beeg-hardware/stepdown-pc/stepdown-pc.kicad_pcb

## KiCad design stepdown-pc.kicad_pcb (2022-09-27)

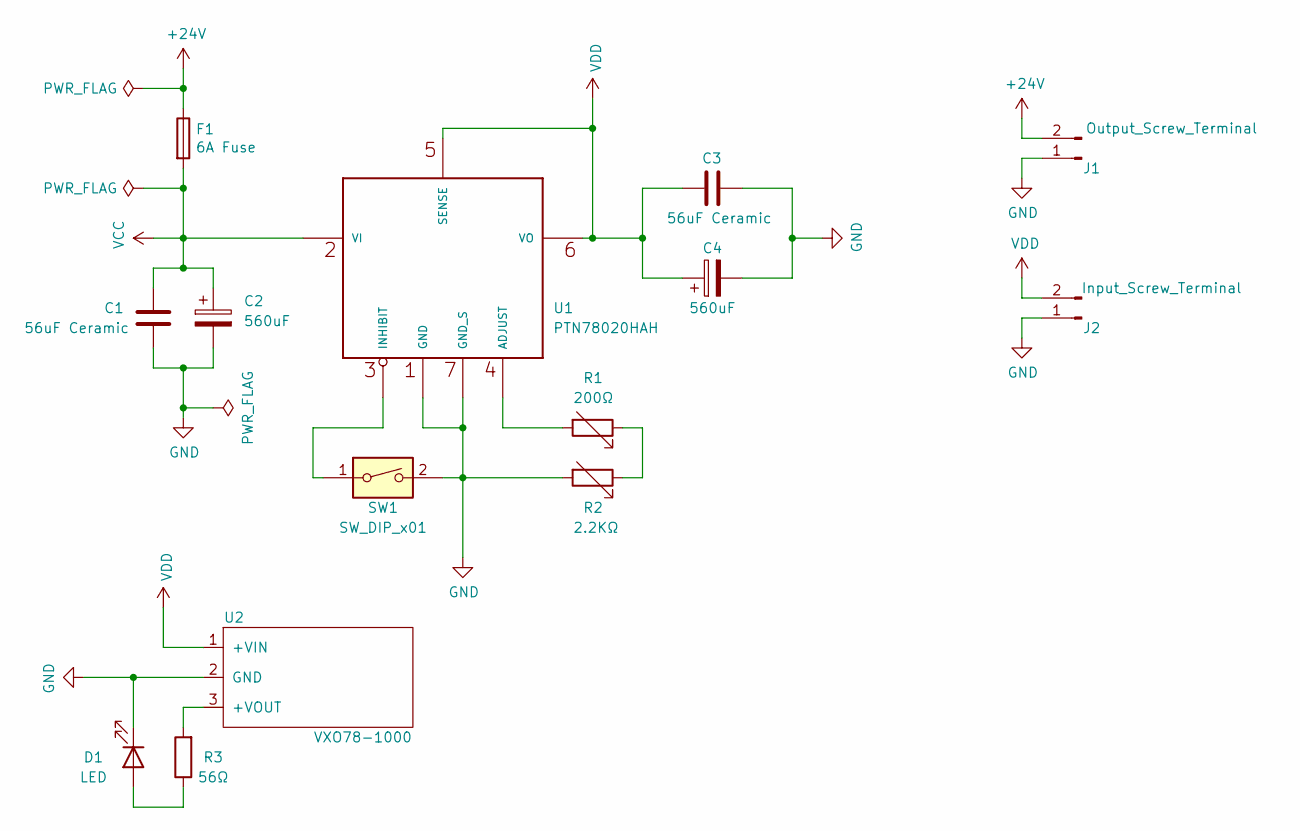
[picture p1: schematic stepdown-pc.kicad_sch, Stepdown PC]

Parts:
C1, C3: 56uF Ceramic; C_Rect_L7.0mm_W3.5mm_P5.00mm
C2, C4: 560uF; CP_Radial_D18.0mm_P7.50mm
D1: LED; LED_Rectangular_W3.0mm_H2.0mm
F1: 6A Fuse; Fuseholder_Cylinder-5x20mm_Littlelfuse_520_Horizontal_Open
J1: Output_Screw_Terminal; PhoenixContact_MSTBA_2,5_2-G-5,08_1x02_P5.08mm_Horizontal
J2: Input_Screw_Terminal; PhoenixContact_MSTBA_2,5_2-G-5,08_1x02_P5.08mm_Horizontal
R1: 200Ω; Potentiometer_Piher_Amphenol_PT-10-V10_Vertical_Hole
R2: 2.2KΩ; Potentiometer_Piher_Amphenol_PT-10-V10_Vertical_Hole
R3: 56Ω; R_Axial_DIN0207_L6.3mm_D2.5mm_P10.16mm_Horizontal
SW1: SW_DIP_x01; SW_DIP_SPSTx01_Slide_9.78x4.72mm_W7.62mm_P2.54mm
U1: PTN78020HAH
U2: VXO78-1000

Connections:
+24V: F1.1, J1.2
GND: C1.2, C2.2, C3.2, C4.2, D1.1 (K), J1.1, J2.1, R2.2, SW1.2, U1.1 (GND), U1.7 (GND_S), U2.2 (GND)
unnamed: D1.2 (A), R3.1
unnamed: R1.1, R2.1
unnamed: R1.2, U1.4 (ADJUST)
unnamed: R3.2, U2.3 (+VOUT)
unnamed: SW1.1, U1.3 (INHIBIT)
VCC: C1.1, C2.1, F1.2, U1.2 (VI)
VDD: C3.1, C4.1, J2.2, U1.5 (SENSE), U1.6 (VO), U2.1 (+VIN)

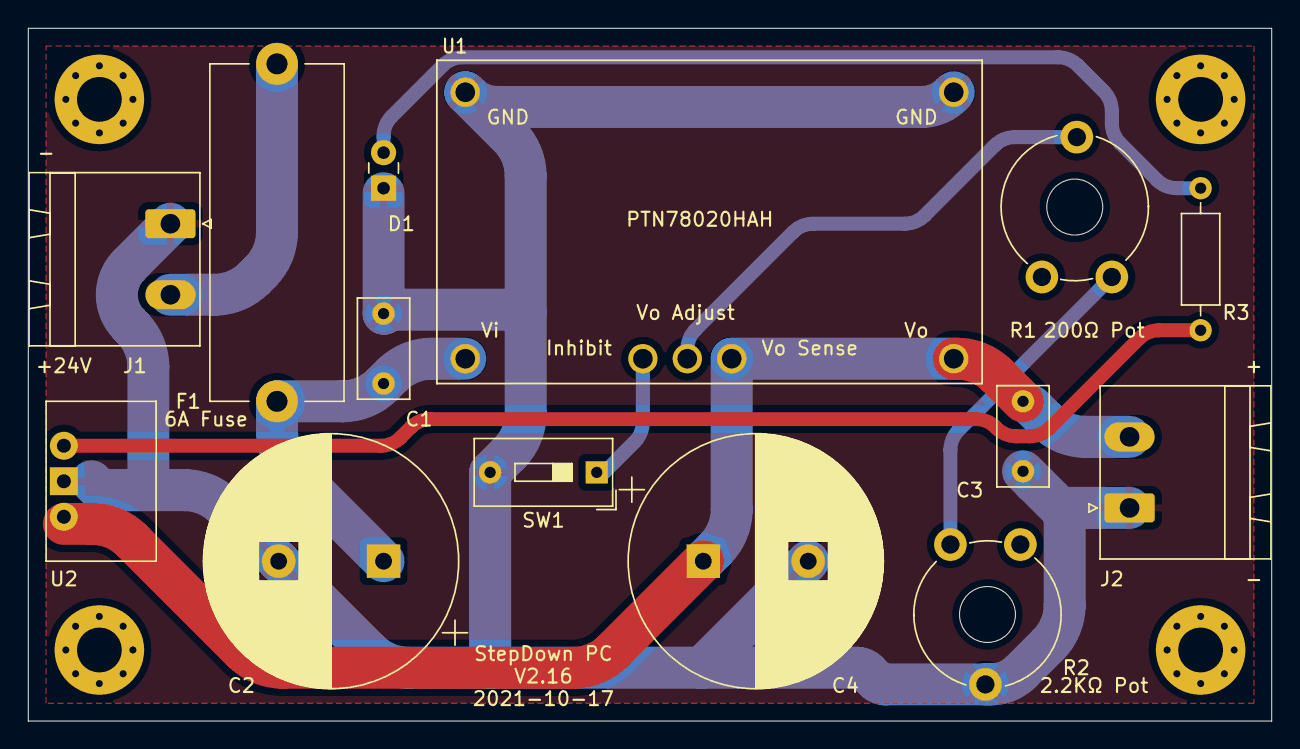
[picture p2: board stepdown-pc.kicad_pcb from above]

Board: 2 copper layers, 88.9 x 49.5 mm, 18 parts (0 on the bottom side), 9 nets.

Other parts of the board:
H1, H2, H3, H4: MountingHole_3.2mm_M3_Pad_Via
